huszen001/campus-smart-locker/docs/演示脚本.md

# 扣费功能 · 现场演示脚本

给**演示的人**用：照着敲、照着说。全程约 8 分钟，核心是后面几幕（费用上涨 → 结算 → 欠费冻结 → 充值恢复）。

> 这份脚本只讲**扣费**这一条线。状态机、防越权、超时兜底那几条按 README 演示，
> 可以拼在一起，也可以只演这一条。

---

## 0. 提前 5 分钟准备

### 起后端（用演示参数）

**必须新开一个 cmd 窗口**，在同一个窗口里先 `set` 再启动：

```bat
cd D:\ClaudeWorkspace\campus-locker\backend
set PYTHONUTF8=1
set FREE_SECONDS=15
set UNIT_SECONDS=10
.venv\Scripts\python.exe app.py
```

| 变量 | 真实值 | 演示值 | 效果 |
|---|---|---|---|
| `FREE_SECONDS` | 1800（30 分钟） | **15** | 免费窗口 15 秒 |
| `UNIT_SECONDS` | 3600（1 小时） | **10** | 每满 10 秒收 ¥1 |
| `UNIT_FEE_FEN` | 100 | 100 | 不变，仍是 ¥1 |
| `MAX_FEE_FEN` | 1000 | 1000 | 不变，仍是 ¥10 封顶 |

**逻辑一条没改**，只是把秒数压小。这一点要在台上说出来 —— 否则老师会以为你写了个假规则。

> ⚠️ `set` 和启动**必须在同一个 cmd 窗口**。双击 `start.bat` 开的是新窗口、新环境，
> 不带这几个变量 —— 那正好是演示完恢复真实参数的办法。

### 记下地址

启动横幅会打印几个地址，用**局域网 IP** 那个：

```
监控台   http://192.168.x.x:5000/?k=<口令>
扫码页   http://192.168.x.x:5000/scan            ← 柜体总码（存件自动挑格）
         http://192.168.x.x:5000/scan?box=1      ← 1 号柜格的码
```

**这一场默认用总码那条**（`/scan`，不带 `box`）：存件时格由后端挑，取件凭码找格，
演示的人不需要记住"东西在第几格"。柜格贴（`/scan?box=N`）留着当对照 ——
想看"锁定某一格"的差别时再打开。

**把监控台和扫码页并排摆在屏幕上**（两个浏览器窗口，或者一块屏分两半）。
后面所有戏剧性都来自"左边页面点一下，右边表格里数字自己往上跳"。

### 起设备（真机，2026-10-16 已验通）

**板子已经回来了，整套固件跑在真 ESP32 上**：WiFi、MQTT、MFRC522 刷卡、
SG90 舵机、0.96" OLED、HX711 物品检测 —— 存件和取件两条闭环都当场走过。

上电就行，**不需要额外起任何进程**。但有一条硬要求：

> ⚠️ **开机前把托盘清空。** 零点就是开机那一下取的（去皮），
> 托盘上放着东西时重启，那东西会被当成零点，之后一直报"空" ——
> 而且**光看屏幕看不出来**，它显示的就是"无物"，一切正常的样子。
> 自救：清空托盘重启，或者在串口里敲 `t` 重新去皮。
>
> 还有一条：**秤的载重余量不大**（实测约等于 6 本书），演示物别挑太沉的。详见 README。

**兜底方案（真出问题才用）**：`device_sim.py --door-hold 1` 顶替设备那一层，
只换掉 MQTT 那一段，后端和计费逻辑完全一样。

> **但这是兜底，不是默认。** 有真板子却跑模拟器，等于把最能加分的东西藏起来 ——
> 而且模拟器还验不了"舵机开锁 ≠ 门被打开"那个竞态，那条只有真簧片才暴露。

**要演刷卡，得先确认是"已绑卡"的号** —— 读卡器实测能读到 UID，但后端还要拿 UID 去
`users.card_uid` 里找人，**没绑过的卡只会回一句"未绑定"**。当前的状态：

| 手里的真卡 UID | 绑在谁身上 | 能演什么 |
|---|---|---|
| `6B492D54` | `13600136001`（测试用户，¥50） | ✅ 刷卡存件 / 取件，都能演 |
| `4EED0629` | `13600136002`（测试用户，余额 ¥0） | ✅ 也能存也能取 —— 余额 ¥0 **不算欠费**（闸门是 `< 0`）。想演"欠费拦住存件"，就用这张卡存一次再取一次，费用一扣余额转负，**下次刷卡存件被拦** |
| `929B5789` / `3EA9B19E` | 没绑 | 故意演示"未绑定卡"这条拒绝路径 |

> ⚠️ **上面那张"三个账号"表里的号一个都没绑卡** —— 刷卡和扫码是两条入口，
> 别指望拿 `13800138000` 去刷。要用刷卡就单独用这两张已绑的卡，
> 或者现场在管理页先绑一张（登录时也给一个绑定窗口，见 README「注册与绑卡」）。

### 硬件这摊怎么讲（提前想好，主动说）

> "柜体和主控板联调通了 —— 存件、取件、刷卡、门不关超时，这几条都跑过真机。
> **1 号格是真硬件**：SG90 舵机、门磁簧片、HX711 压力传感器。
> 2 到 4 号格是固件虚拟的 —— 里面跑个计时器，到点自己发'门开了''门关了'，
> 报文格式和真机一模一样，后端一行都没改。"

被问"为什么不全做成真的"：

> "舵机 + 门磁 + 秤是 4 根线，四格要 16 根，这块板子的可用脚不够 ——
> **这是演示取舍，不是没做完**。多格这件事要验的是'后端怎么分格'，
> 那部分四格是全部在真跑的。"

被问"要是有人开了门、什么都没放就把门关上呢？"（这题大概率会被问，是加分题）：

> "这一单会**判失败**，不放行、也不发码。因为'门关了'只说明门关了 ——
> 东西到底进没进去，**只有秤知道**。所以固件在关门回执里把它秤出来的结论
> （有物 / 空）一起报上来，后端拿它和这一单的动作对一下：存件时报'空'就是没放进去，
> 取件时报'有物'就是没拿走，两种都判 failed，柜格立刻放开。
> 反过来，后端还会拿秤的读数和订单记录**持续对账** —— 万一两者分家了
> （东西被拿走了、记录还挂着），30 秒内会自己把那条脏记录判失败，不用人去改库。"

### 这次要用的三个账号

| 手机号 | 余额 | 用来演 |
|---|---|---|
| `13800138000` 演示学生 | ¥50 | 正常扣费（余额够） |
| `13900139000` 张三 | ¥50 | 免费窗口 |
| `13700137000` **现场注册** | **¥0** | 欠费冻结 → 充值恢复 |

为什么欠费那一幕要用**现场注册的新号**？因为**新用户的初始余额是 0**，
而种子用户有 ¥50 —— 单次扣费封顶 ¥10，怎么扣都扣不成负数，
拿老号演不出欠费。现场注册一个新号，用真实规则就能演出来，不用改数据库。

---

## 1. 开场：先讲钱在哪算（40 秒）

打开监控台，手指点一下顶部那行计费说明：

> "这是个寄存柜，不是免费储物柜。规则是：存件后 **30 分钟**内取走免费，
> 之后每满 **1 小时**收 **1 元**，单次最多 10 元。费用从**存件人**的余额里扣。
> 现在为了演示把时间压成了 15 秒 / 10 秒 —— **页面上写的规则是后端给的**，
> 所以它写的就是真规则，不是我改的文案。"

再指一下设备那一栏：

> "**计费全在后端，固件一行都没改。** 设备只是个执行器：收到开门命令就开锁，
> 回一个门磁回执。它不知道钱的事 —— 钱的事放设备上就是等着被刷。"

---

## 2. 第一幕：存件，费用当场开始涨

1. 左边扫码页 → **存件** → 填 `13800138000` → 点「存件」。
2. 页面弹 6 位取件码。
3. **指右边监控台**的订单表：新那一行，动作 = 存件，状态 `done`，费用一栏是
   橙色的 **`≈¥0.00`**。

> ⚠️ **码是"正在开门"那一刻就发的，不等于已经存成。** 这一行要等**关上门**才落定 ——
> 关门到状态变 `done` 大约 1 秒（固件关门后先等 400ms 让门停稳、再读一次秤）。
> 所以措辞用"码在这儿，**关门之后这一行才会变 done**"，
> 别说"码出来了就是存好了" —— 万一没放稳，这一单会被判 `failed`。

> "注意那个 **≈** 和橙色 —— 表示东西还在柜里，费用还在涨。取件单才不会涨。"

**然后开始等，并且一直盯着那一格。** 15 秒后它开始跳：

```
≈¥0.00  →  ≈¥1.00  →  ≈¥2.00  →  ≈¥3.00 …
```

**这是全场最值钱的 20 秒**，别浪费：用它讲免费窗口的边界。

> "前 15 秒是免费的，所以一直停在 0。第 16 秒开始跳 —— 免费时长不是'打个折'，
> 是**完全不进计费**。之后每满 10 秒加 1 块，**不足 10 秒也按 10 秒算**，
> 所以是往上取整，不会出现 0.3 元这种零头。"

**等到 ≈¥3.00 再往下走**（大概存完 40 秒，多等几秒也行，账是照算的）。

---

## 3. 第二幕：取件，结算并真的扣钱

1. 左边扫码页 → **取件** → 粘贴取件码 → 点「取件」。
2. 页面出绿字：**「取件成功，本次费用 ¥3.00」**。
3. 监控台：该订单状态 `done`，费用变成**白色定死的 `¥3.00`**（`≈` 没了）；
   下拉到「钱包」面板，多出一条流水。

> "门关上的那一刻结算。`¥3.00` 是从**存件单的门关闭时间**算到**取件单的门关闭时间**，
> 中间所有时间都算他的 —— 包括东西放在那儿一直没动的那段时间。"

指钱包面板：

> "扣费记一条流水，**同时改余额**。这两件事在同一个事务里，中间没有窗口能让它们对不上。"

**再点一次「取件」**（同一个码）：

> "取件码失效了 —— 东西已经取走了。"（回 403「取件码不对」）

> 这里刻意**不说**"这个码不存在"还是"东西已取走"：存件码只有 6 位，
> 分开报等于告诉别人哪些码是真的。两种情况回同一句话、同一个状态码。

**顺便把重复扣费的防线说了**（老师大概率会问，主动说更从容）：

> "就算设备把门磁回执重复发一遍，也不会重复扣钱。状态推进是**条件更新**，
> 第二次推不动；就算推到了，流水那张表上还有唯一索引兜底。"

---

### （可选）加演 30 秒：四格是怎么分开的

**时间紧就跳过**，不跳过的话这是"多格"这件工作唯一的展示机会。
刚取完件、1 号格空着，正好接着演：

1. 扫码页（总码，`/scan`）→ `13800138000` 存件 → 页面写
   **「正在开门…请把物品放进 1 号柜格后关好门」**，下面还挂一行「存放位置：1 号柜格」
   —— 1 号格是空的，自动挑最小的格。
2. **不取件**，直接换 `13900139000` 再存一次 → **「…放进 2 号柜格后关好门」**。
   监控台上 1 号、2 号格同时是「有物品」。
3. 把**第二个**码贴进取件框（页面上**没有任何地方填格号**）→ 页面回
   **「物品在 2 号柜格，正在开门」**，监控台上 2 号格清空、**1 号格纹丝不动**。

> "扫的是柜体总码，页面上从头到尾没有格号 —— **东西在哪一格是后端找的**：
> 它按取件码去每一格里核对，核对得上才开门。所以用户根本不用记自己存在第几格，
> 记个码就行。"
>
> "码是**全局唯一**的，生成的时候扫着整个表，用过就不再复用 —— 不然两个格拿到同一个码，
> 按码找格就会瞎。"
>
> "为什么不按'格号 + 手机号'找？因为**一个人可以同时占好几格**，
> 刚才这两单就是两个人，但换成同一个人也一样能占两格。"

**顺便说清楚哪几格是真的**（这问题一定会被问）：

> "柜子做了 4 格，但**只有 1 号格装了真硬件** —— 舵机、门磁、秤。2 号往后是固件虚拟的：
> 里面跑个计时器，到点自己发'门开了''门关了'，报文格式和真机一模一样，后端一行没改。
> 为什么不全做真的：这三样东西是 4 根线，四格要 16 根，这块板子的可用脚不够 ——
> **这是演示取舍，不是没做完**。"

---

## 4. 第三幕：免费窗口，真的不收费

节奏要快，两个动作连着做：

1. 换 `13900139000` 存件 → 拿到新取件码。
2. **马上**取件 —— 15 秒内完成。

页面出绿字：**「取件成功，在免费时长内，本次不收费」**。

> "同一套代码、同一个函数，只是这次没超时。免费和收费是**同一个算式**出来的，
> 不是两条 if 分支。"

监控台钱包里会多一条 **¥0.00 的扣费流水** —— 主动指出来：

> "0 元也记一条账。看着多余，其实是必需的：后面那个补账的后台线程靠'有没有流水'
> 判断这一单结没结算，不记的话它会以为没结，每 2 秒重算一次。"

---

## 5. 第四幕：欠费冻结（这幕最能说明设计取舍）

**现场注册一个新号**，顺便把注册流程也演了：

1. 扫码页 → 底部「我的 · 余额 / 绑卡 / 注册」→ **「还没注册？点这里注册」** →
   填姓名 + `13700137000` → 注册。
2. 注册完自动回到「我的」页，手机号已经带过来了。**看一眼余额：`¥0.00`**。

> "新用户初始余额是 0。"

3. 用 `13700137000` **存件** —— 注意，**0 元是允许存的**。
4. 等 40 秒让费用涨到 ≈¥3.00 → 取件。
5. 回「我的」页：余额变成 **`-¥3.00`**（红色）。

> "余额不够**照样能取走东西**。这是故意的 —— 东西扣在柜里比欠费更糟，
> 而且柜子里可能是别人的东西。先让他拿走，账挂着。"

6. 再试着用 `13700137000` 存件 → 页面出红字：
   **「账户欠费，请充值后再存件」**。

> "欠费冻结的是**存**，不是**取**。反过来才荒唐：欠了钱就不让你取自己的东西。
> 这套规则在**两条入口上是一致的** —— 扫码和刷卡走同一个闸门，
> 不会出现'扫码拦住了、刷卡绕过去了'。"

想展开就说一句：这道闸门在扫码链路上返回 **HTTP 402**，
刷卡链路上回 `{"result":"deny","reason":"balance"}` —— 同一个判断，两种出口。

> **边界要说清楚**：0 元能存一次，等于允许"先取走再欠"。单次能欠的上限就是封顶那
> ¥10。真实场景里这一步会接信用分或校园卡代扣，课设没做。

---

## 6. 第五幕：用户在手机上自己充回来

**接着 402 那一下往下走** —— 被拦时页面会自动跳到「我的」页，
余额 `-¥3.00`（红色）就在眼前，正下方就是充值按钮。

1. 点 **「充 ¥20」**。
2. 绿字：**「充值成功，余额 ¥17.00」**（−3 + 20 = 17）。
3. 回存件页再存一次 —— **通过了**。

> "欠费之后用户**自己在手机上就走出来了**，不用去找管理员。
> 这一点很重要 —— 充值口要是只开在管理端，'欠费冻结'就是个死循环：
> 人被冻住了，解冻却要别人批准。"

指一下按钮下面那行小字：

> "写着**模拟支付** —— 课设不接真实支付通道，点一下就到账，不产生任何真实交易。
> 老实标出来比假装接通了微信支付可信。"

**然后补一句这是全流程里唯一一处"不设防"的地方**，主动说，别等老师挑：

> "这个支付接口**没有做身份校验** —— 知道手机号就能给它充值。
> 这跟存件接口的现状是一样的（存件也只填手机号，没有登录态），所以并没有更弱。
> 但真实上线，这一条必须换成**支付平台的异步回调加签名校验** ——
> 不能让客户端说充多少就是多少。这是课设和真实系统差距最大的一处，
> 我把它留在明面上。"

---

### （可选）补一句管理端也能充

> "监控台那边还有一个充值入口，要走管理员口令 —— 那是我用来做**代充和补偿**的。
> 两种充值走同一个函数，流水里的备注区分是'模拟支付'还是'管理员充值'。"

---

## 7. 收尾：一句话总结

> "这一版加了钱包和计费。规则本身是四个环境变量，演示时压成 15 秒和 10 秒，
> 真实值是 30 分钟和 1 小时 —— **同一套代码**。钱全程用整数分算，不碰浮点；
> 扣费有事务、有唯一索引、有补账线程，断电或者进程被杀也能补回来。"

---

## 老师可能问的问题

**Q：这个充值是假的吧？**
> 是假的，页面上也写着「模拟支付」。课设不接真实支付通道 —— 接进来也是假的。
> 关键是**流程走完整了**：欠费 → 自助充值 → 恢复，用户不用找管理员。
> 真接微信支付要先有商户资质和备案，拿不到；能改的是这个接口的**位置**：
> 真实系统里它由支付平台的异步回调驱动，钱到账了后端才加余额，客户端说了不算。

**Q：为什么费用在后端算，不在设备上算？**
> 设备是开锁执行器，也是最容易被拆、被刷的一环。放在设备上等于把计价器装在被收钱的人手里。
> 设备只回"门开过、门关过"两个事实，时间由后端自己记。

**Q：余额扣成负数，这不就是白嫖吗？**
> 单次白嫖有上限（封顶 ¥10，而且是先取走再欠）。代价是账户被冻结，不能再用。
> 替代方案是把东西扣在柜里 —— 更糟：柜子被别人占着，而且他的东西凭什么扣。
> 真实场景里这一步会接信用分或校园卡扣款，课设没做。

**Q：为什么计费对象是存件人，不是取件人？**
> 取件人可能只是拿了码的朋友。用服务的是存件人，账记在他头上才对。
> 这也是为什么取件单要存一个 `store_id` 指回存件单 —— 不然算不出放了多久。

**Q：为什么不能靠"柜格号 + 手机号"找存件单？**
> 一开始是因为只有一格，柜格号恒等于 1、没有区分力。现在有四格了，这条路还是不行 ——
> **一个人可以同时占好几格**（扫柜格贴就能一格一格地存），所以"格 + 手机号"仍然指不回
> "哪一张存件单"。只有显式的 `store_id` 是准的：取件单创建时就写上它指的那张存件单，
> 计费才有一个确定的起算时刻。

**Q：为什么刷卡就能开对格子？读卡器又不知道我站在哪一格前。**
> 对，RC522 是全柜共用的，它读到的只是一张卡。所以"刷哪一格"是**后端按卡主算出来的**：
> 这张卡的主人占着哪一格，就是取件、开那一格；一格都没占，就是存件、从在线的空格里挑。
> 好处是**格号不经过设备**，卡主算出来的格不可能是别人占着的 ——
> 原来那条"卡主不是这格占用者"的拒绝分支因此整条消失了。

**Q：2 号、3 号格没有硬件，怎么还能开门？**
> 假的，固件自己演的 —— 里面跑一个 3 秒的计时器，到点自己发"门开了""门关了"，
> 报文格式和真机一模一样，后端一行都不用改。为什么不全做真硬件：
> 舵机 + 门磁 + 秤是 4 根线，四格就 16 根，这块板子伸出来的可用脚不够。
> 所以是"1 格真家伙 + 3 格虚拟"，这属于演示取舍，不是没做完。

**Q：进程在扣费前被杀怎么办？**
> 后台每 2 秒扫一次"状态是 `done`、但没有对应扣费流水"的取件单，补上。
> 靠唯一索引保证不会重复扣。

**Q：30 分钟免费是不是太长了？**
> 短是刻意的：再长就没人付费，这功能等于不存在。30 分钟够放下东西去吃顿饭、
> 收个快递；超过就该掏钱了。这条阈值是环境变量，改一个数就行。

**Q：真实运营怎么定价？**
> 现在是"每满 1 小时 ¥1、封顶 ¥10"，是拍出来的课设值。
> 真要上线得看周转率 —— 定价的目的是让柜子别被长期霸占，不是靠它赚钱。

---

## 万一出问题

| 现象 | 原因 | 怎么办 |
|---|---|---|
| 费用一栏一直是 `—` | 订单不是这格当前的占用者，或取件单还没结算 | 刷新监控台；确认那一单状态是 `done` |
| 费用一直 `≈¥0.00` 不涨 | 免费窗口还没过 | 看监控台顶部那行写的"免费 X 秒"是不是 15 |
| 顶部还写着"30 分钟" | 后端没带演示参数启动 | 关掉重开，`set` 和启动必须在**同一个 cmd 窗口** |
| 存件回 402 | 该手机号欠费了 | 这正是第四幕要演的效果；页面会自动跳到「我的」，点「充 ¥20」 |
| 存件回 409 | 指定那一格里还有东西，或**四格全满了** | 先走一次取件把格清空；满柜时页面会说"没有空闲柜格" |
| 存件回 503 | 设备离线 | 板子掉线了。先看串口（WiFi 断了会打 `[wifi] 掉线，重连…`）和屏幕上那一行；热点没开、手机锁屏、板子被碰掉线，都是常见原因 |
| 监控台上某几格显示**离线** | 心跳没上来 | **不正常**。整套固件给四格都发心跳，**四格应该全在线**；掉格子说明设备断线或心跳丢包 |
| 扫码页 404 | `?box=` 的格号不存在（比如打印的是旧贴纸） | 格号超过 4 就是贴纸/链接写错了，别改代码，改链接 |
| 注册返回"该手机号已经注册过了" | 上一场演示已经注册过 `13700137000` | 换个号（如 `13700137001`），或者去钱包给它充值继续演 |
| **1 号格存不进去**，页面总说"这格里还有东西"，可格子明明是空的 | 订单表里还挂着一条 `done` 的存件单，而秤说格内无物 —— DB 和秤分家了（历史上"门关了但东西没放进去"留下的脏单） | **等 30 秒**：后端对账会自动把它判 `failed` 并放掉那格，后端窗口里能看到 `[reconcile] 1 号格：订单 #N 判为假存件 -> failed，柜格解锁`。新固件已从源头不发这种单了，但**别手工改库** |
| 东西明明放进去了，页面却说"这次没成功（东西没放进去）" | 关门那次采样**漏判**了 —— 秤的门限是 8000 计数，而实测"一本书"在关门瞬间只有 1.17 倍余量（约 9382），放得轻、没压实、刚好在门边松手都可能读不到 | 把东西**往里放稳、压实一点再关门**；演示物别挑太轻的。这是**已知缺口**（关机判定前不等读数稳住），重演一次就好 |
| **连着好几单存件全失败**，每单原因都是"门关了但秤报格内为空"，可东西确实放进去了 | **重启时托盘上有东西**，开机去皮把那件东西的重量整个当成了零点，之后放同一件东西差值恒等于 0（2026-10-22 真机撞出来的：板子 09:18 重启一次，之后 5 单 5 败，重新上电后一单就成） | 判据：审计里**连续多单**都是同一句"格内为空"，就不是偶发漏判了。**清空托盘**后重启，或串口敲 `t` 重新去皮，看 `[scale] 差` 回到 ±50 以内。这也是为什么「起设备」那节要求**空托盘上电**——USB 接触不良会自己重启，这条最容易踩 |
| 存件时秤一直显示空，关门那一下才判到有物 | 东西放得太晚。关门那次重新采样只有约 **1.2 秒**的窗口（`delay(400)` + 舵机 `delay(400)` + 采 4 个样本），实测开门后 6 秒读数都还是 0、全靠这个窗口兜住的 | **东西放稳了再关门**，别在门已经推上去的瞬间才脱手 |

## 演示完的收尾

1. 双击 `start.bat` 起后端 → 恢复真实的 30 分钟 / 1 小时。
2. 想看看账（只读，不影响正在跑的后端）：

```bat
.venv\Scripts\python.exe dbq.py users     :: 按余额升序，欠费的排最前
.venv\Scripts\python.exe dbq.py wallet    :: 充值 + 扣费流水
```

3. 现场注册的那个演示号会留在库里（余额 ¥17）。不影响别的功能，
   要清掉走监控台充值把它补正即可。
